raaslab/cad_3dprints/Renderings/Assembly3.jpg

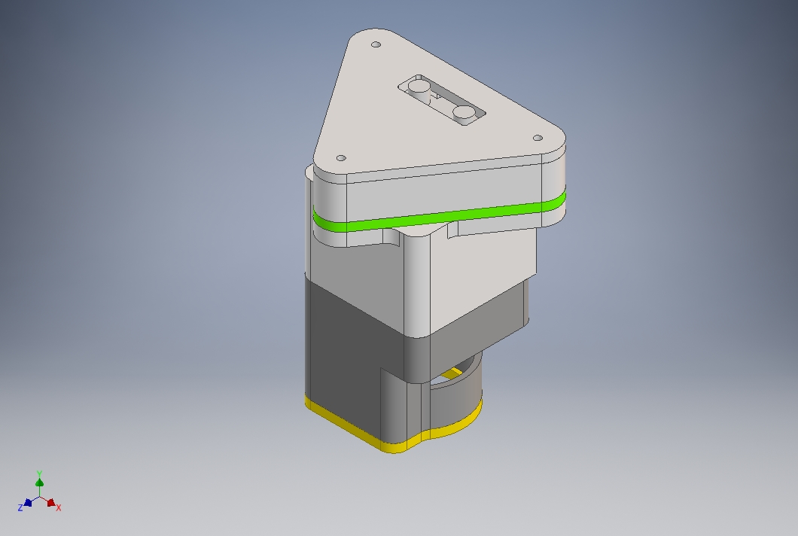
Renderings/Assembly3.jpg
