raaslab/cad_3dprints/450 Landing Gear (Hollow Thick)/landing gear hollow (8mm).stl

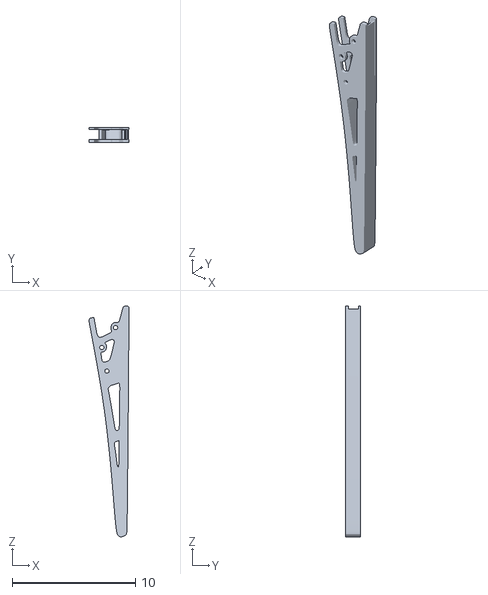
[picture p3: CAD file, 2017-11-10]
450 Landing Gear (Hollow Thick)/landing gear hollow (8mm).stl
3.23 x 1.25 x 18.7
