raaslab/cad_3dprints/450 Landing Gear/450leg_rev6.stl

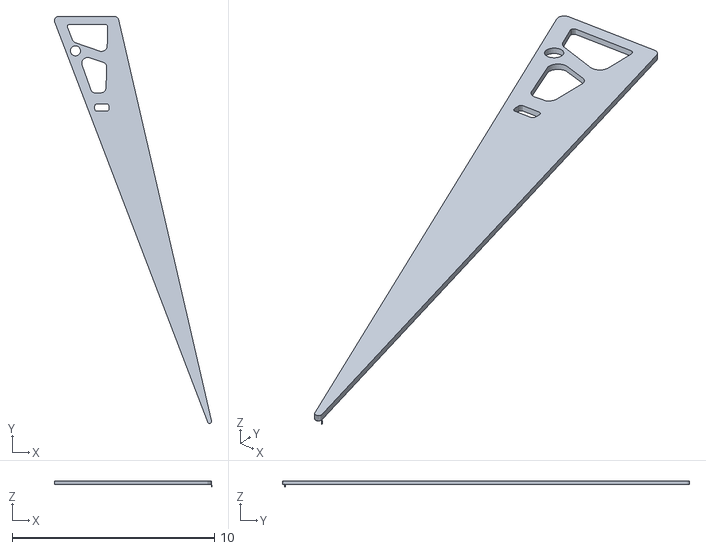
[picture p4: CAD file, 2017-06-29]
450 Landing Gear/450leg_rev6.stl
7.77 x 20.1 x 0.28
