raaslab/cad_3dprints/Camera Mount/Jonah's camera mount REV1.STL

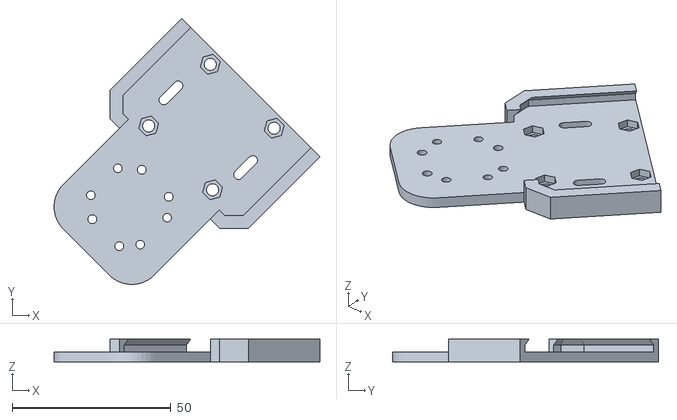
[picture p5: CAD file, 2017-11-10]
Camera Mount/Jonah's camera mount REV1.STL
83.7 x 83.7 x 7.20
