raaslab/cad_3dprints/IR Lock Mount/IR Lock Mount.stl

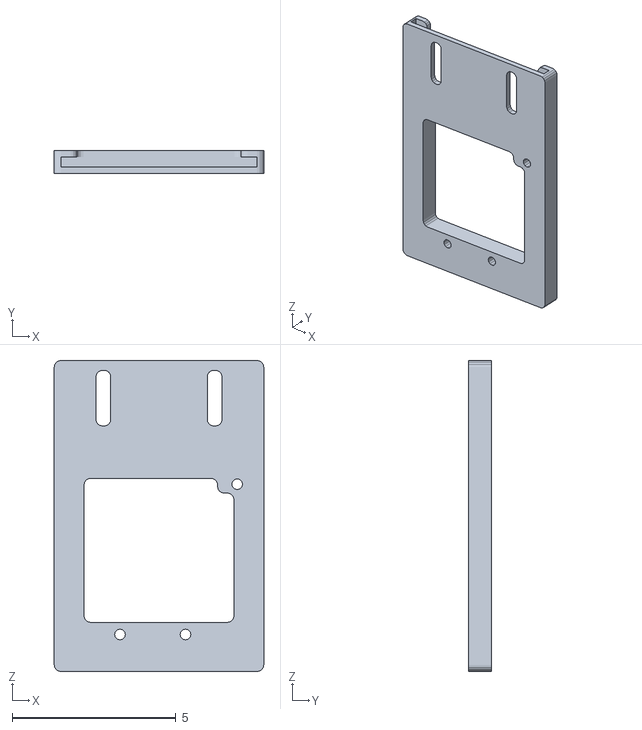
[picture p6: CAD file, 2017-07-06]
IR Lock Mount/IR Lock Mount.stl
6.40 x 0.7 x 9.50
