raaslab/cad_3dprints/Lidar Mount/LiDAR Mount.STL

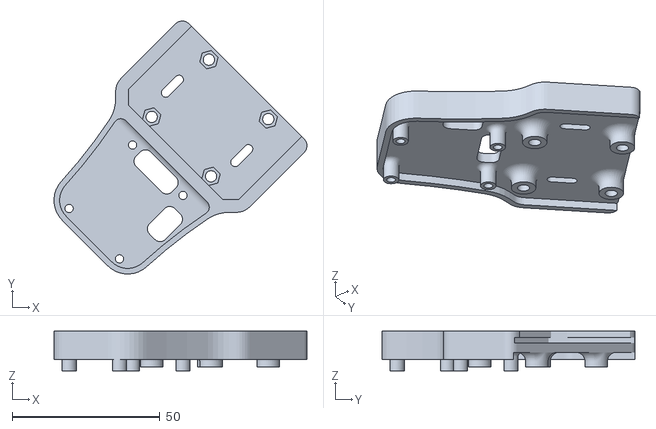
[picture p7: CAD file, 2017-06-26]
Lidar Mount/LiDAR Mount.STL
85.7 x 85.7 x 13.5
