raaslab/cad_3dprints/NUC Mount - for Scanse Sweep/Jonah's Mod - NUC Plate.STL

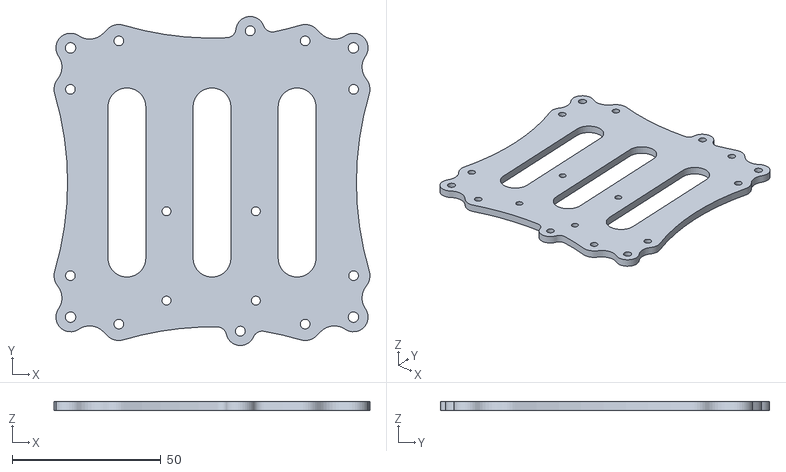
[picture p8: CAD file, 2017-11-10]
NUC Mount - for Scanse Sweep/Jonah's Mod - NUC Plate.STL
106.1 x 110.5 x 3.17
