raaslab/cad_3dprints/Pioneer Screen Mounts/StandV1.stl

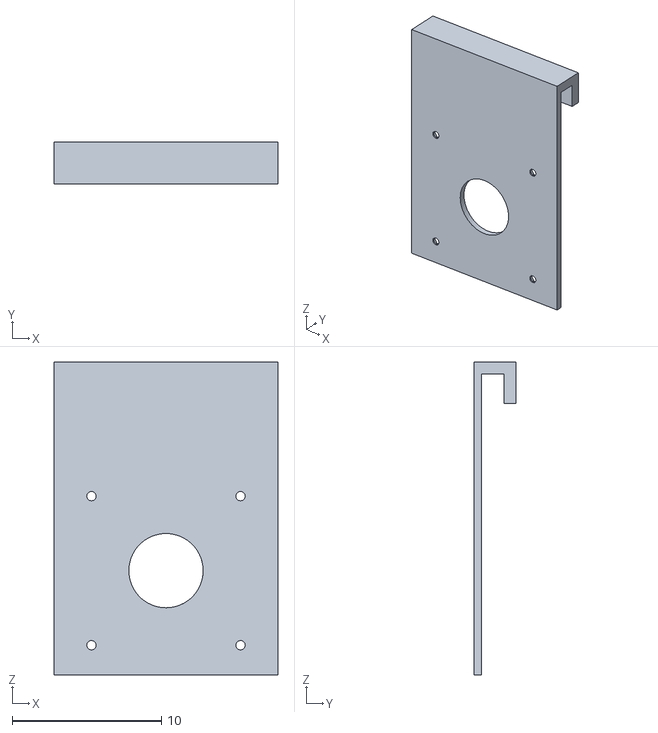
[picture p9: CAD file, 2017-07-04]
Pioneer Screen Mounts/StandV1.stl
15.0 x 2.80 x 21.0
