raaslab/cad_3dprints/Rtk Mount/RTK Mount.stl

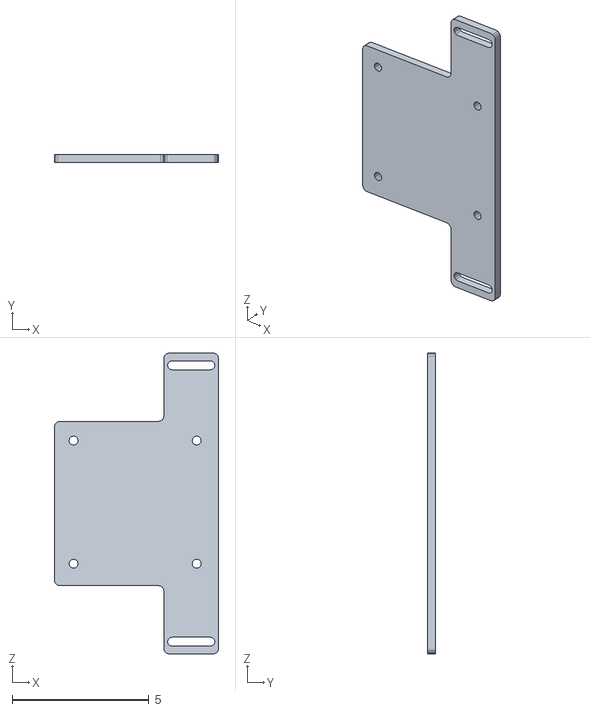
[picture p10: CAD file, 2017-06-29]
Rtk Mount/RTK Mount.stl
6.00 x 0.3 x 11.0
