raaslab/cad_3dprints/Camera Mount/flea3_mount2_450 - cube.stl

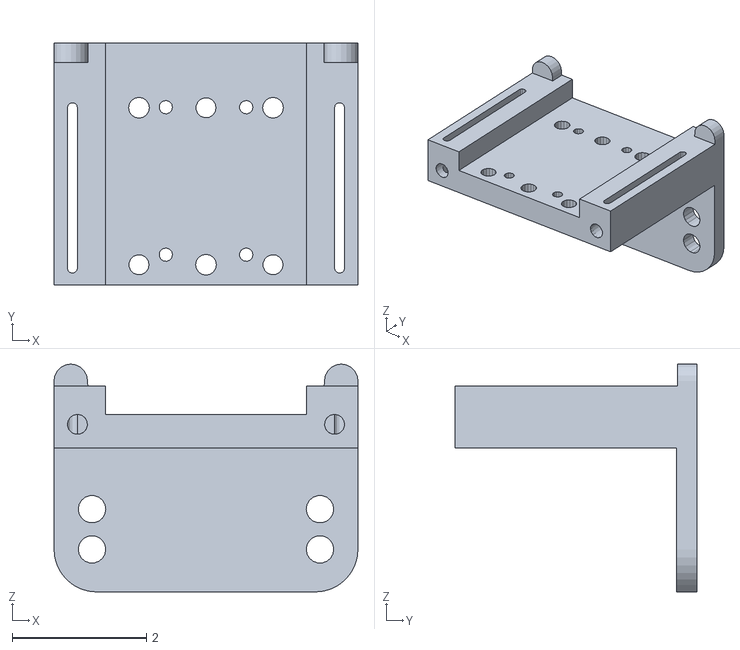
[picture p11: CAD file, 2017-06-26]
Camera Mount/flea3_mount2_450 - cube.stl
4.53 x 3.61 x 3.40
