raaslab/cad_3dprints/Camera Mount/mount2_450 - cube.stl

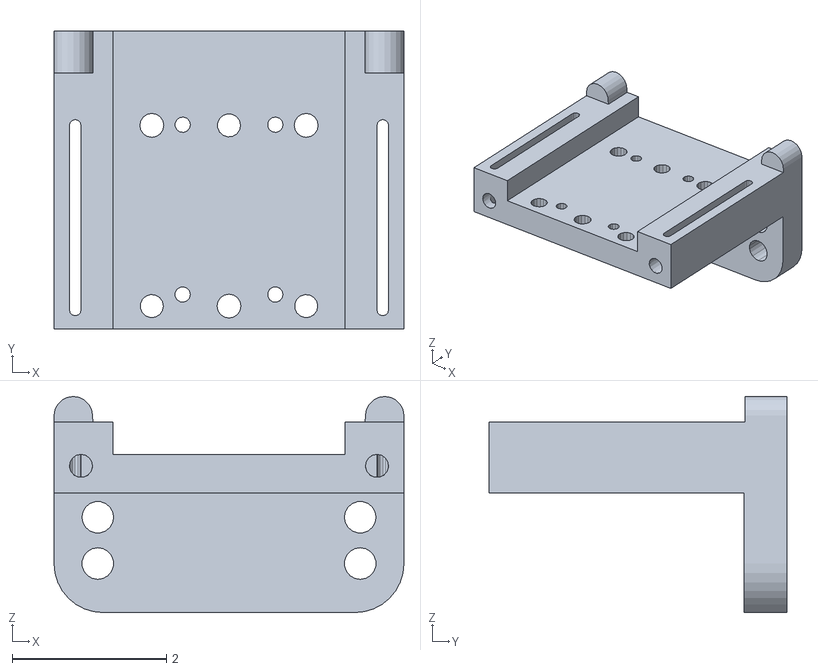
[picture p12: CAD file, 2017-06-03]
Camera Mount/mount2_450 - cube.stl
4.53 x 3.87 x 2.80
