raaslab/cad_3dprints/Camera Mount/3mm.STL

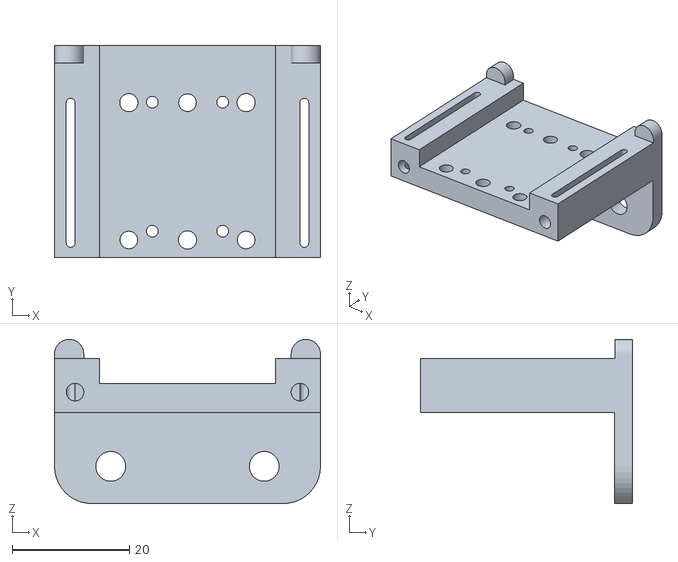
[picture p13: CAD file, 2017-04-15]
Camera Mount/3mm.STL
45.4 x 36.2 x 28.0
