raaslab/cad_3dprints/Camera Mount/5mm.STL

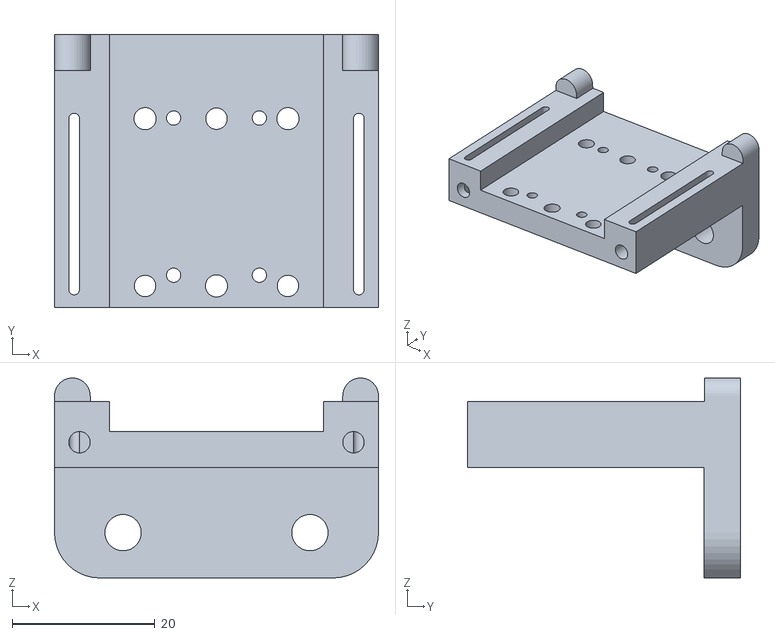
[picture p14: CAD file, 2017-04-15]
Camera Mount/5mm.STL
45.4 x 38.2 x 28.0
