raaslab/cad_3dprints/Camera Mount/4.5mm.STL

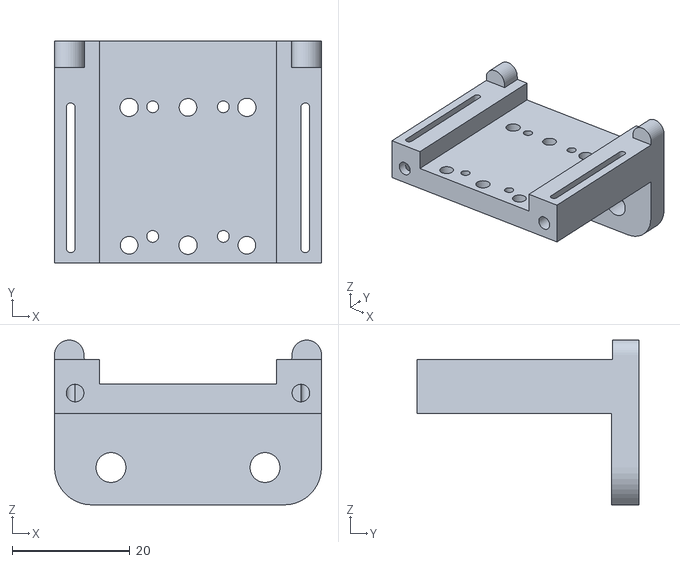
[picture p15: CAD file, 2017-04-15]
Camera Mount/4.5mm.STL
45.4 x 37.7 x 28.0
