raaslab/cad_3dprints/450 Landing Gear/landing gear_stl.stl

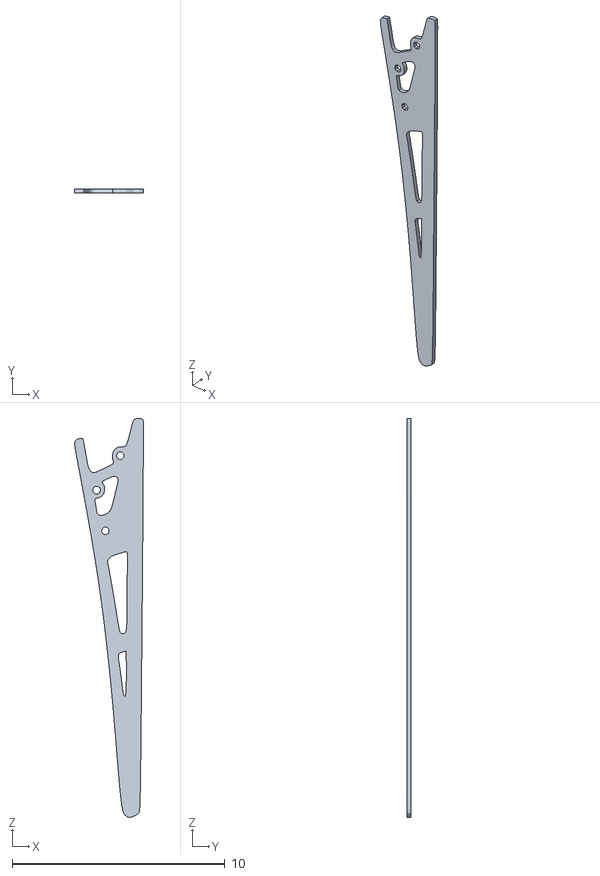
[picture p16: CAD file, 2017-06-03]
450 Landing Gear/landing gear_stl.stl
3.23 x 0.203 x 18.7
