raaslab/cad_3dprints/Camera Mount/5.5mm.STL

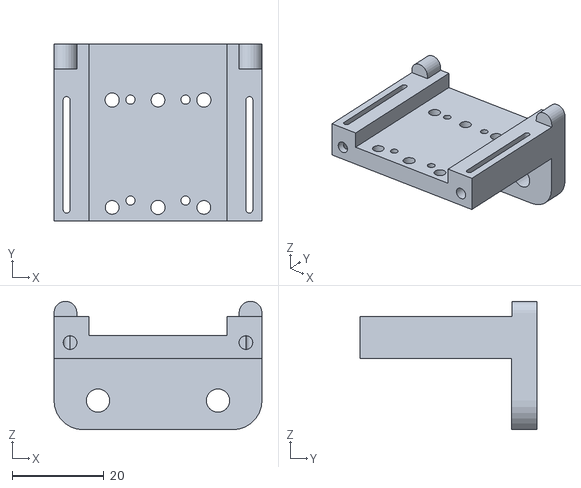
[picture p17: CAD file, 2017-04-15]
Camera Mount/5.5mm.STL
45.4 x 38.7 x 28.0
