raaslab/cad_3dprints/Camera Mount/3.5mm.STL

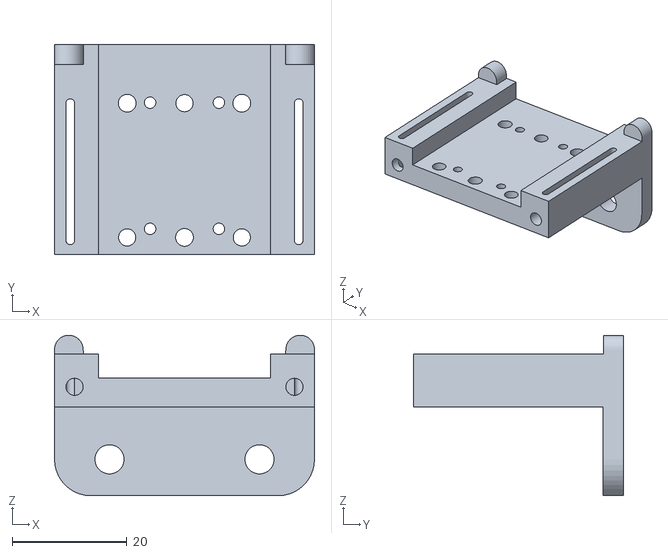
[picture p18: CAD file, 2017-04-15]
Camera Mount/3.5mm.STL
45.4 x 36.7 x 28.0
