raaslab/cad_3dprints/Camera Mount/4mm.STL

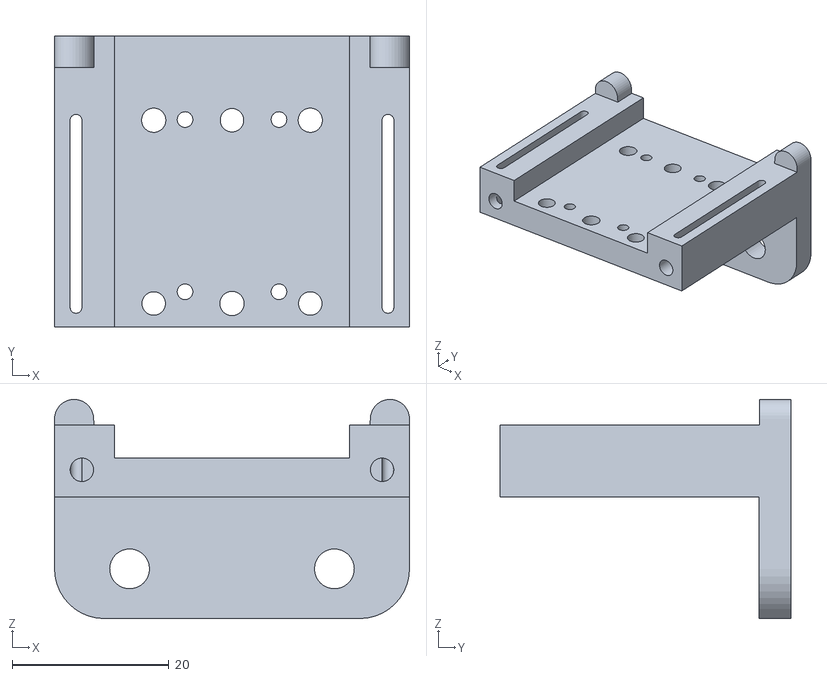
[picture p19: CAD file, 2017-04-15]
Camera Mount/4mm.STL
45.4 x 37.2 x 28.0
