raaslab/cad_3dprints/(list of files, cad)

Other CAD files:
NUC Mount/NUC_Mounting_Plate.STL
Camera Mount/mount2 - cube.sldprt
450 Landing Gear (Hollow Thick)/OldVersions/landing gear hollow (8mm).0004.ipt
450 Landing Gear (Hollow Thick)/landing gear hollow (8mm).ipt
450 Landing Gear/20mmlonger_f450leg.ipt
450 Landing Gear/450leg_rev0.stl
450 Landing Gear/450leg_rev1.stl
450 Landing Gear/450leg_rev2.stl
450 Landing Gear/450leg_rev3.stl
450 Landing Gear/450leg_rev4.stl
450 Landing Gear/450leg_rev5.stl
450 Landing Gear/OldVersions/20mmlonger_f450leg.0006.ipt
450 Landing Gear/landing gear.ipt
Camera Mount/Assembly3.SLDASM
Camera Mount/Assembly3.STL
Camera Mount/mount2 - cube.STL
Camera Mount/mount2 - cube.ipt
IR Lock Mount/IR Lock Mount.ipt
IR Lock Mount/OldVersions/IR Lock Mount.0002.ipt
OldVersions/mount2 - cube.0007.ipt
Pioneer Screen Mounts/OldVersions/Stand.0004.ipt
Pioneer Screen Mounts/Stand.ipt
Pioneer Screen Mounts/Stand.stl
Pioneer Screen Mounts/flat_100mm_vesa_mount.ipt
Rtk Mount/RTK Mount.ipt
px4 Flow/OldVersions/px4 Flow Mount.0001.ipt
px4 Flow/px4 Flow Mount.ipt
