raaslab/cad_3dprints/Renderings/Assembly3 Exploded Drawing.pdf

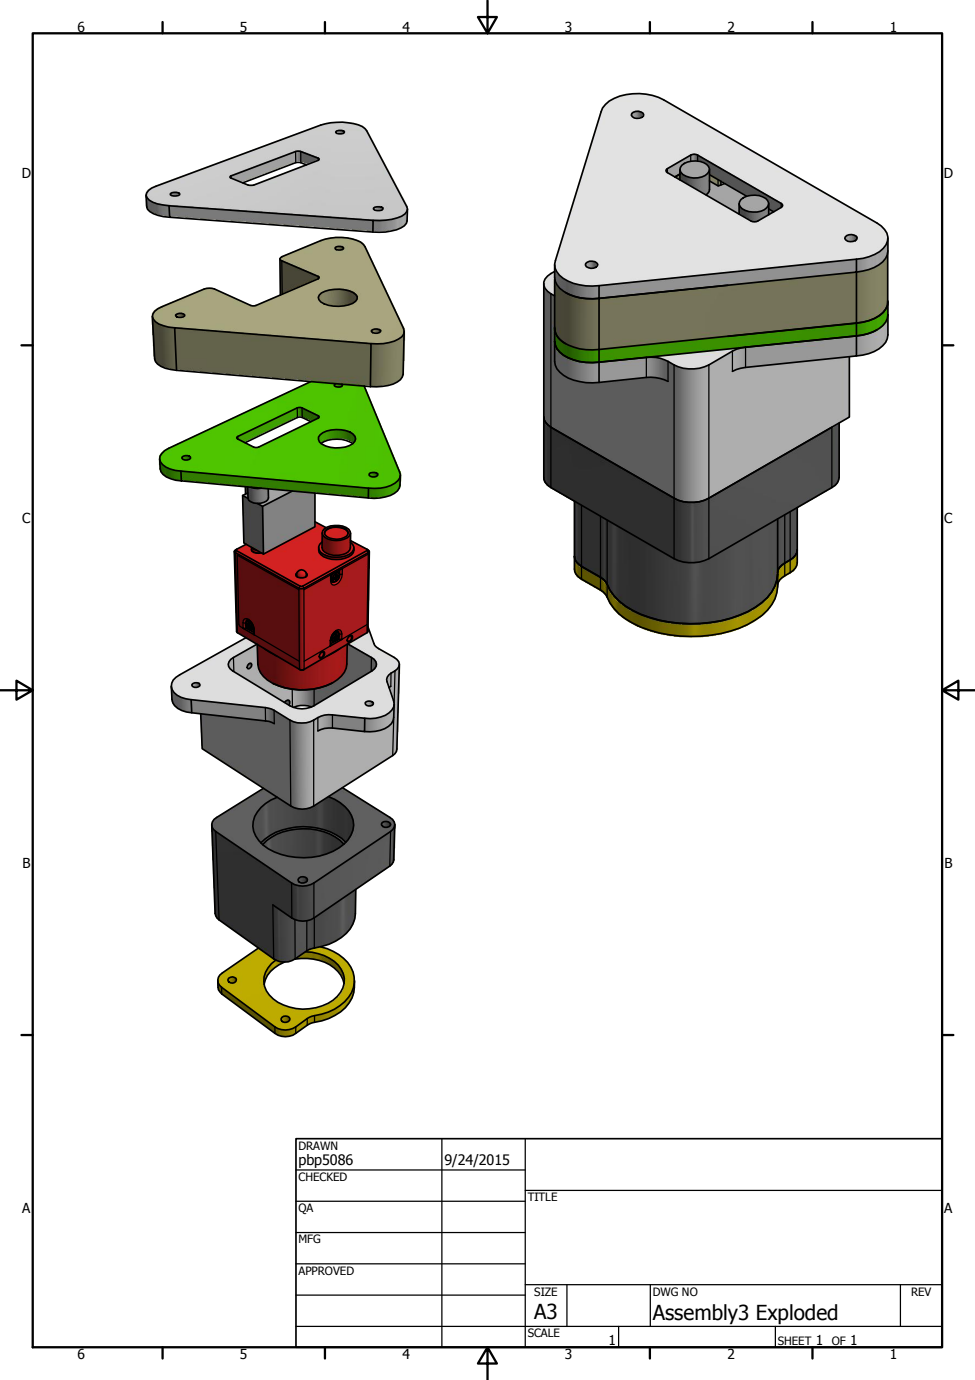
[picture p20: page 1]
SHEET 1 OF 1; DRAWN; CHECKED; MFG; APPROVED; pbp5086; DWG NO Assembly3 Exploded; TITLE; SIZE A3; SCALE; REV
