raaslab/cad_3dprints/(commit log)

2017-06-03 added landing gear for 450 and flea3 cam mount for 450
    [landing gear.ipt, landing gear_stl.stl, mount2 - cube.ipt, mount2_450 - cube.stl]
2017-06-26 Added Lidar Mount
    [LiDAR Mount.STL]
2017-06-26 new files
    [NUC_Mounting_Plate.STL, flea3_mount2_450 - cube.stl, mount2 - cube.0007.ipt, mount2 - cube.ipt]
2017-06-29 added some files for 450 landing/organized repo
    [20mmlonger_f450leg.0006.ipt, 20mmlonger_f450leg.ipt, 3.5mm.STL, 3mm.STL, 4.5mm.STL, 450leg_rev0.stl, 450leg_rev1.stl, 450leg_rev2.stl]
2017-06-29 added RTK Mount
    [RTK Mount.ipt, RTK Mount.stl]
2017-07-04 added new stand .stl
    [StandV1.stl]
2017-07-06 added IR Lock Mount
    [IR Lock Mount.0001.ipt, IR Lock Mount.ipt, IR Lock Mount.stl]
2017-07-06 updated IR Lock Mount
    [IR Lock Mount.0001.ipt, IR Lock Mount.0002.ipt, IR Lock Mount.ipt, IR Lock Mount.stl]
2017-08-27 added a new mount for px4flow
    [px4 Flow Mount.0001.ipt, px4 Flow Mount.ipt]
2017-11-10 added new camera mount
    [Jonah's Mod - NUC Plate.STL, Jonah's camera mount REV1.STL, landing gear hollow (8mm).0004.ipt, landing gear hollow (8mm).ipt, landing gear hollow (8mm).stl]
